uxabix/UVExpose/Schematics/UV_Expose/UV_Expose.pdf

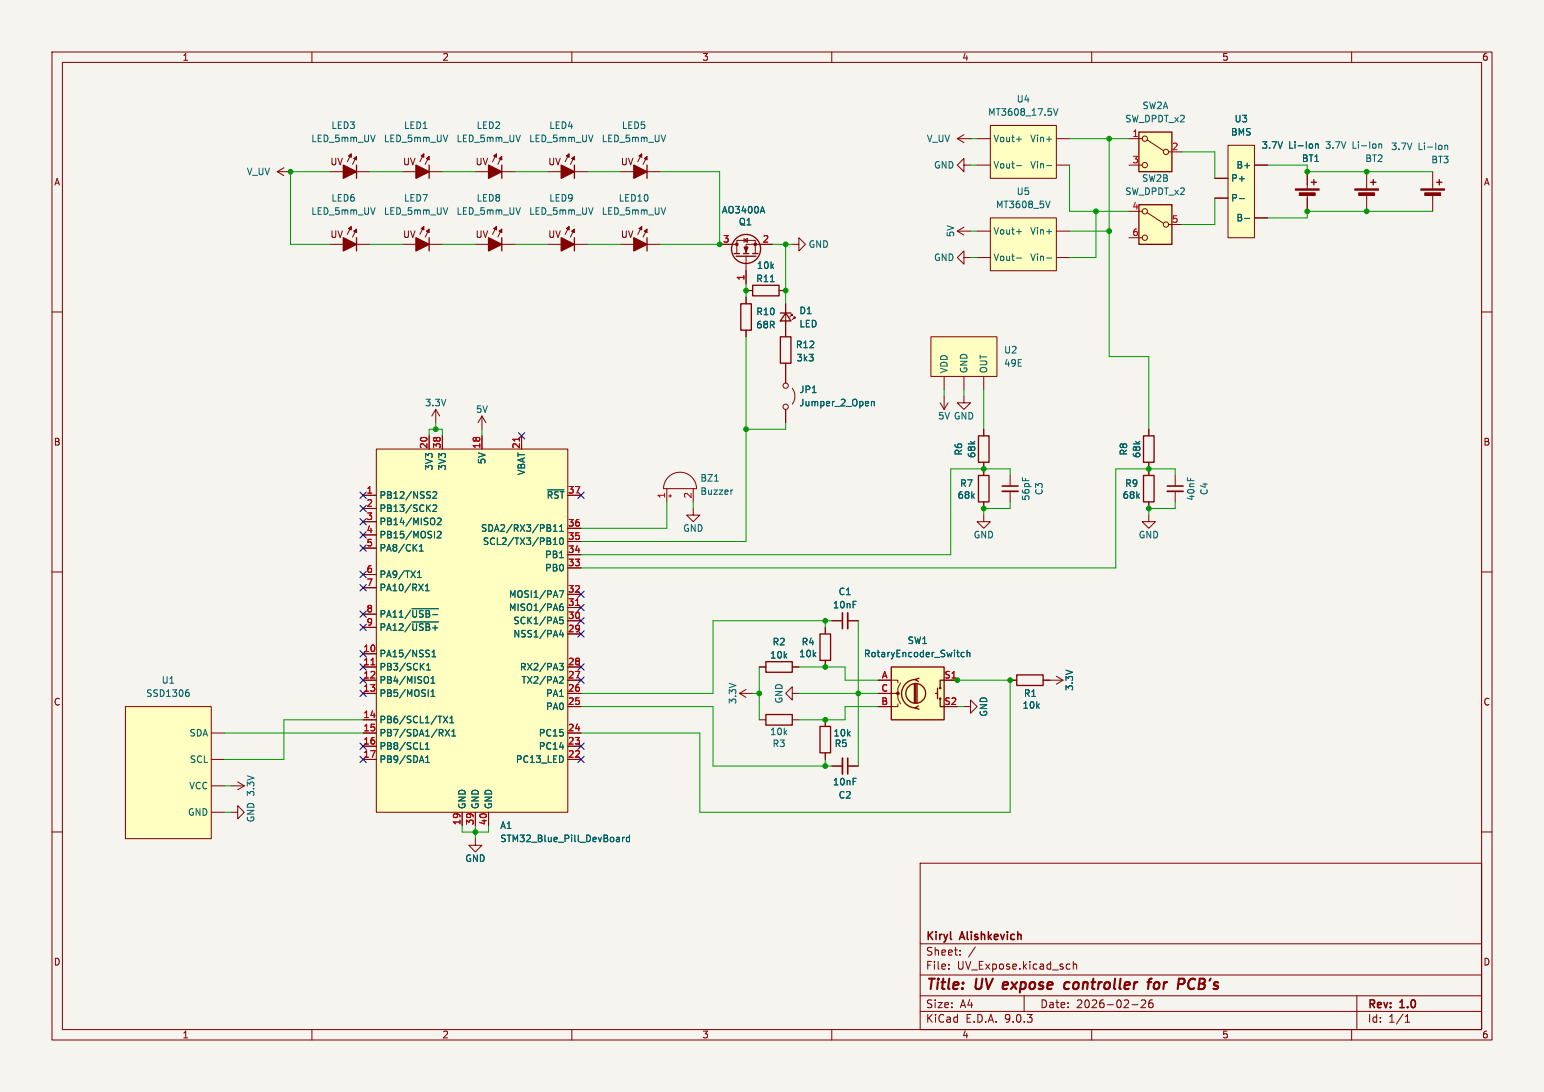
[picture p1: page 1]

File: UV_Expose.kicad_sch Sheet: / Kiryl Alishkevich

Id: 1/1 Title: UV expose controller for PCB's
