uxabix/UVExpose/Schematics/UV_Expose/UV_Expose.kicad_sch

## KiCad design Schematics/UV_Expose/UV_Expose.kicad_sch (2026-02-26)

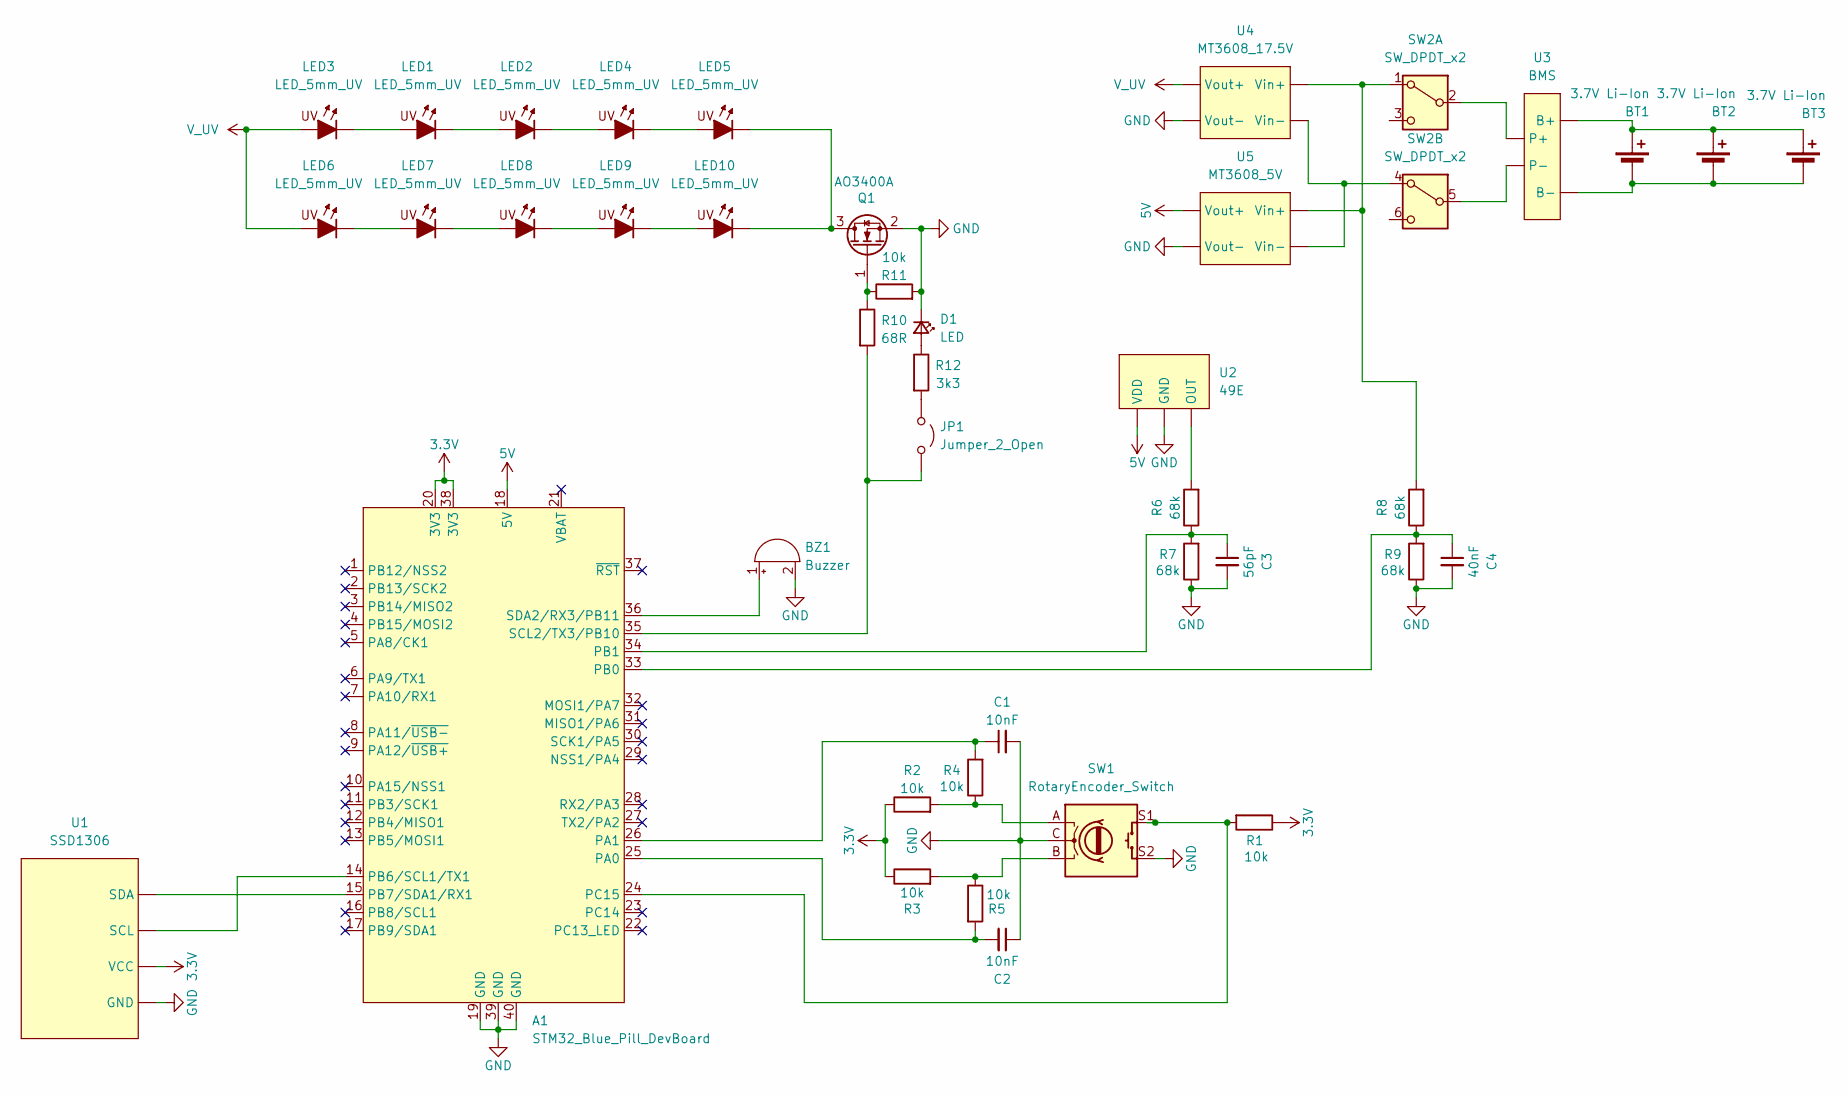
[picture p2: schematic UV_Expose.kicad_sch]

Parts:
A1: STM32_Blue_Pill_DevBoard
BT1, BT2, BT3: 3.7V Li-Ion
BZ1: Buzzer
C1, C2: 10nF; C_0603_1608Metric
C3: 56pF; C_0603_1608Metric
C4: 40nF; C_0603_1608Metric
D1: LED; LED_0603_1608Metric
JP1: Jumper_2_Open
LED1, LED2, LED3, LED4, LED5, LED6, LED7, LED8, LED9, LED10: LED_5mm_UV; LED_D5.0mm_Clear
Q1: AO3400A; SOT-23
R1, R2, R3, R4, R5, R11: 10k
R6, R7, R8, R9: 68k
R10: 68R
R12: 3k3
SW1: RotaryEncoder_Switch
SW2: SW_DPDT_x2
U1: SSD1306
U2: 49E
U3: BMS
U4: MT3608_17.5V
U5: MT3608_5V

Connections:
3.3V: A1.20 (3V3), A1.38 (3V3), R1.1, R2.1, R3.1, U1.
5V: A1.18 (5V), U2., U5.
GND: A1.19 (GND), A1.39 (GND), A1.40 (GND), BZ1.2 (-), C1.2, C2.1, C3.2, C4.2, D1.1 (K), Q1.2 (S), R7.1, R9.1, R11.2, SW1.C, SW1.S2, U1., U2., U4., U5.
unnamed: A1.14 (PB6/SCL1/TX1), U1.
unnamed: A1.15 (PB7/SDA1/RX1), U1.
unnamed: A1.24 (PC15), R1.2, SW1.S1
unnamed: A1.25 (PA0), C2.2, R5.2
unnamed: A1.26 (PA1), C1.1, R4.2
unnamed: A1.33 (PB0), C4.1, R8.1, R9.2
unnamed: A1.34 (PB1), C3.1, R6.1, R7.2
unnamed: A1.35 (SCL2/TX3/PB10), JP1.2 (B), R10.2
unnamed: A1.36 (SDA2/RX3/PB11), BZ1.1 (+)
unnamed: BT1.1 (+), BT2.1 (+), BT3.1 (+), U3.
unnamed: BT1.2 (-), BT2.2 (-), BT3.2 (-), U3.
unnamed: D1.2 (A), R12.1
unnamed: JP1.1 (A), R12.2
unnamed: LED1.1 (K), LED2.2 (A)
unnamed: LED1.2 (A), LED3.1 (K)
unnamed: LED2.1 (K), LED4.2 (A)
unnamed: LED4.1 (K), LED5.2 (A)
unnamed: LED6.1 (K), LED7.2 (A)
unnamed: LED7.1 (K), LED8.2 (A)
unnamed: LED8.1 (K), LED9.2 (A)
unnamed: LED5.1 (K), LED10.1 (K), Q1.3 (D)
unnamed: LED9.1 (K), LED10.2 (A)
unnamed: Q1.1 (G), R10.1, R11.1
unnamed: R2.2, R4.1, SW1.A
unnamed: R3.2, R5.1, SW1.B
unnamed: R6.2, U2.
unnamed: R8.2, SW2.1 (A), U4., U5.
unnamed: SW2.2 (B), U3.
unnamed: SW2.4 (A), U4., U5.
unnamed: SW2.5 (B), U3.
V_UV: LED3.2 (A), LED6.2 (A), U4.
