uxabix/UVExpose/Core/Inc/main.h

#define LED_Debug_Pin GPIO_PIN_13
#define LED_Debug_GPIO_Port GPIOC
#define ENC_BTN_Pin GPIO_PIN_15
#define ENC_BTN_GPIO_Port GPIOC
#define ENC_BTN_EXTI_IRQn EXTI15_10_IRQn
#define EncoderA_Pin GPIO_PIN_0
#define EncoderA_GPIO_Port GPIOA
#define EncoderB_Pin GPIO_PIN_1
#define EncoderB_GPIO_Port GPIOA
#define Battery_Pin GPIO_PIN_0
#define Battery_GPIO_Port GPIOB
#define Hall_Pin GPIO_PIN_1
#define Hall_GPIO_Port GPIOB
#define LED_Output_Pin GPIO_PIN_10
#define LED_Output_GPIO_Port GPIOB
#define Buzzer_Pin GPIO_PIN_11
#define Buzzer_GPIO_Port GPIOB
