uxabix/UVExpose/(commit log)

2026-01-08 Cube IDE project initialization
    I2C and SWD peripherarls, 72mHz Clock speed
2026-01-12 SSD1306 test code and i2c bus configuration set to fast mode
2026-01-12 Basic battery level indication with OLED burnout protection
    [app_controller.c, soft_timer.c]
2026-02-19 Display Timer
2026-02-20 Encoder with button support
2026-02-21 Buzzer with customizable modes
    [UVExpose.ioc, app_controller.c, buzzer.c, exposure_service.c, main.h]
2026-02-21 Introduced config.h and hall sensor support
2026-02-24 Battery voltage control
2026-02-26 KiCad Schematics with images and README update
    [UV_Expose.kicad_pcb, UV_Expose.kicad_sch]
2026-02-28 Battery and Hall info menus
2026-03-01 ADC readings offset, Fix ssd1306_I2C_WriteMulti() sends count instead of count + 1
    [adc_service.c, config.h]
2026-03-01 Imporved battery management
2026-03-01 Encoder inversionб Update README and CONFIG_GUIDE, remove redundant config lines
